francis-walsh/drv8353sm_dev/PCB/DRV8353S_dev_board/Renders/DRV8353S_dev_board.png

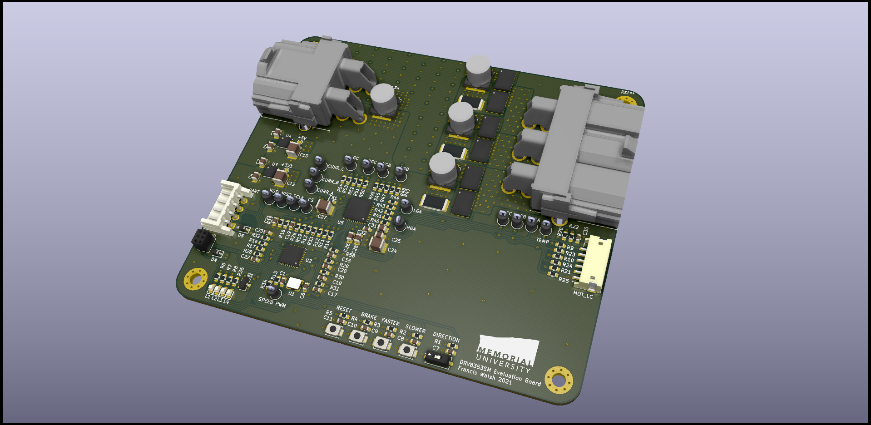
PCB/DRV8353S_dev_board/Renders/DRV8353S_dev_board.png
