francis-walsh/drv8353sm_dev/PCB/DRV8353S_dev_board/componentSelectionSheet.xlsx

Sheet: FETs
Manuf. | MPN | Digi PN | Voltage | Current Rating | Width | Height | Cost Unit | Single or Bridge | Num FETs | Tot Cost
Infineon Technologies | IRFH7545TRPBF | IRFH7545TRPBFCT-ND | 60V | 85A | 5 | 6 | 1.59 | Single | 6 | 9.54
Infineon Technologies | BSC070N10NS5ATMA1 | BSC070N10NS5ATMA1CT-ND | 100V | 80A | 5 | 6 | 2.24 | Single | 6 | 13.44
Diodes Incorporated | DMT12H007LPS-13 | 31-DMT12H007LPS-13CT-ND | 120V | 90A | 5 | 6 | 2.28 | Single | 6 | 13.68
Infineon Technologies | BSC070N10NS3GATMA1 | BSC070N10NS3GATMA1CT-ND | 100V | 90A | 5 | 6 | 2.32 | Single | 6 | 13.92
Infineon Technologies | BSC061N08NS5ATMA1 | BSC061N08NS5ATMA1CT-ND | 80V | 82A | 5 | 6 | 2.42 | Single | 6 | 14.52
Infineon Technologies | BSC040N08NS5ATMA1 | BSC040N08NS5ATMA1CT-ND | 80V | 100A | 5 | 6 | 1.13 | Single | 6 | 6.78
Texas Instruments | CSD19502Q5B | 296-37194-1-ND | 80V | 100A | 5 | 6 | 3.83 | Single | 6 | 22.98
ON Semiconductor | FDMD8680 | FDMD8680OSCT-ND | 80V | 66A | 5 | 6 | 3.9 | Half | 3 | 11.7
STMicroelectronics | STL50DN6F7 | 497-16488-1-ND | 60V | 57A | 5 | 6 | 1.42 | Half | 3 | 4.26
Vishay Siliconix | SQJQ960EL-T1_GE3 | SQJQ960EL-T1_GE3CT-ND | 60V | 63A | 8 | 8 | 2.92 | Half | 3 | 8.76

Sheet: Caps
Manuf. | MPN | Digi PN | Type | Mount Type | Value | Voltage | Tolerance | ESR | W | Depth | Height | Cost Unit | Tot Cost
KEMET | A759KK186M1KAAE075 | 399-A759KK186M1KAAE075-ND | Polymer | THT | 18u | 80V | 20% | 75m | 8 | 8 | 9 | 1.76 | 5.28
Chemi-Con | HHXA630ARA100MF61G | 565-4169-1-ND | Polymer | SMD | 10u | 63V | 0.2 | 120m | 6.6 | 6.6 | 6.1 | 1.91 | 5.73
Rubycon | 63PEV10M6.3X6.1 | 1189-3804-1-ND | Polymer | SMD | 10u | 63V | 20% | 120m | 6.6 | 6.6 | 6.1 | 2.46 | 7.38
Chemi-Con | HHXB630ARA220MF80G | 565-4192-1-ND | Polymer | SMD | 22u | 63V | 20% | 80m | 6.6 | 6.6 | 8 | 1.98 | 5.94
KEMET | A759KS106M2CAAE110 | 399-14157-ND | Polymer | THT | 10u | 160V | 20% | 110m | 8 | 8 | 13 | 1.98 | 5.94
KEMET | A759KS156M2AAAE052 | 399-A759KS156M2AAAE052-ND | Polymer | THT | 15u | 100V | 20% | 52m | 8 | 8 | 13 | 1.91 | 5.73
AVX Corp | 22201C106MAT2A | 478-9622-1-ND | Ceramic | SMD | 10u | 100V | 20% |  | 5.7 | 5 | 2.79 | 2.85 | 8.55 | Same as chum bucket
TDK Corp | CGA6P1X7R1N106M250AC | 445-181609-1-ND | Ceramic | SMD | 10u | 75V | 20% |  | 3.2 | 2.5 | 2.8 | 1.48 | 4.44
TDK Corp | C5750X7S2A106K230KB | 445-13408-1-ND | Ceramic | SMD | 10u | 100V | 10% |  | 5.7 | 5 | 2.5 | 3.1 | 9.3
TDK Corp | CGA9P3X7S2A156M250KB | 445-7948-1-ND | Ceramic | SMD | 15u | 100V | 20% |  | 5.7 | 5 | 2.8 | 4.55 | 13.65
AVX Corp | 12101C475K4Z2A | 478-12101C475K4Z2ACT-ND | Ceramic | SMD | 4.7u | 100V | 20% |  | 3.3 | 2.5 | 2.79 | 1.3 | 3.9 | 3 in a row
Make foot print for 3 tests: 3 parallel 1210s, 1 2220 ceramic, 1 polymer

Sheet: Motor Sheet
Skateboard (https://www.amazon.ca/Retrospec-Drop-Through-Longboard-Skateboard-Complete/dp/B07NXWJ85G)
Wheel Diam | 51 | mm
Wheel Radius | 25.5 | mm
Wheel Circum | 160.14 | mm
Pulley Circum | 46 | mm
Gear Ratio | 2.117647059 | From amazon
Desired Top Speed | 50 | km/h
Desired Top Speed | 13.88888889 | m/s
Wheel w | 544.6623094 | rad/s
Motor w | 1153.402537 | rad/s
Motor RPM | 11014.18293 | RPM
Motor Poles | 14
Electrical Frequncy | 1284.988008 | Hz
