francis-walsh/drv8353sm_dev/PCB/DRV8353S_dev_board/3D LIB/ECS-320-12-33B-7KM-TR.STEP

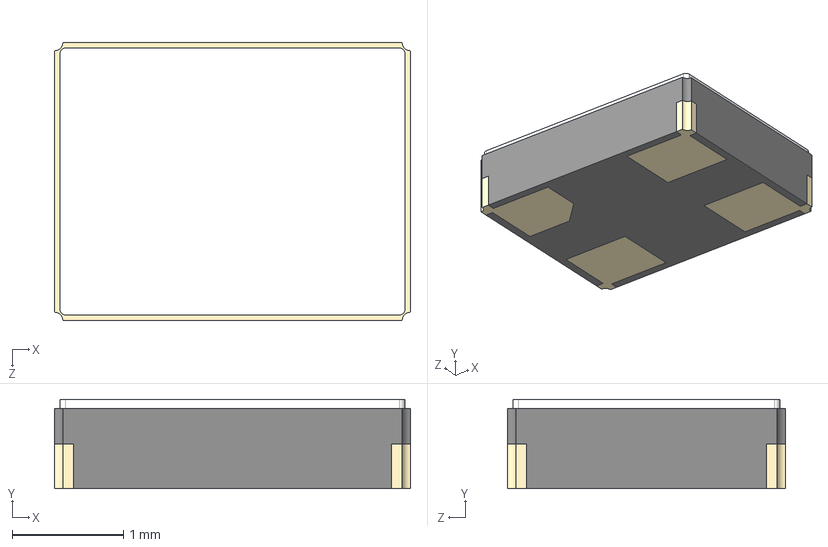
[picture p3: CAD file, 2021-02-27]
PCB/DRV8353S_dev_board/3D LIB/ECS-320-12-33B-7KM-TR.STEP
3.20 x 0.8 x 2.50 mm
