francis-walsh/drv8353sm_dev/PCB/DRV8353S_dev_board/3D LIB/keystone-PN5001.STEP

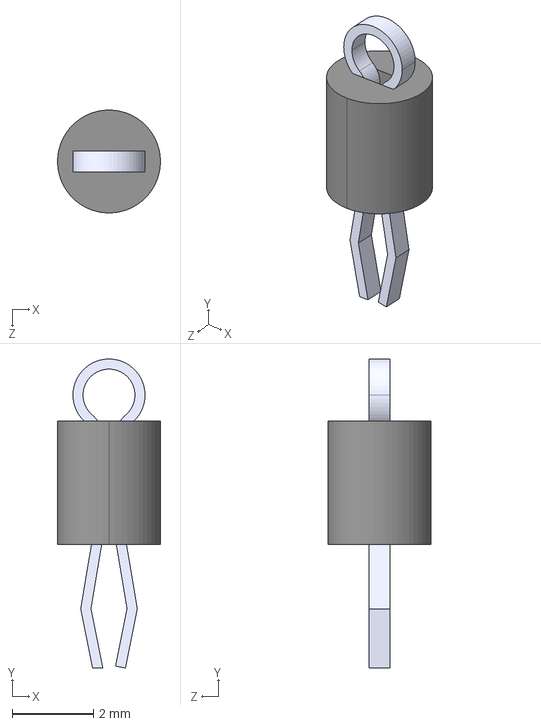
[picture p4: CAD file, 2021-02-27]
PCB/DRV8353S_dev_board/3D LIB/keystone-PN5001.STEP
2.54 x 7.62 x 2.54 mm
