francis-walsh/drv8353sm_dev/PCB/DRV8353S_dev_board/3D LIB/CAP_PEVPFV_6P3X6P1_RUB.step

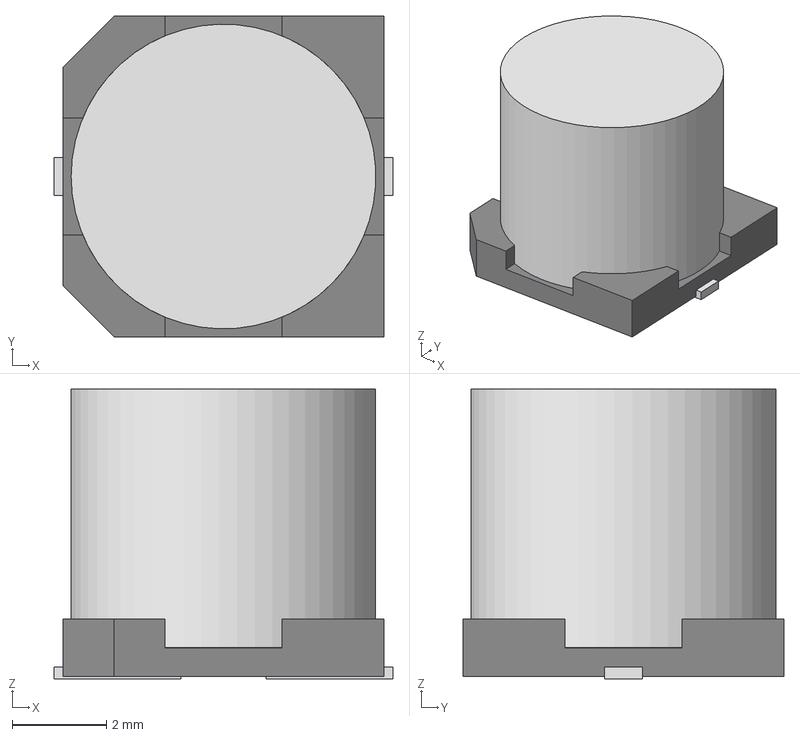
[picture p5: CAD file, 2021-02-27]
PCB/DRV8353S_dev_board/3D LIB/CAP_PEVPFV_6P3X6P1_RUB.step
7.19 x 6.81 x 6.15 mm
