francis-walsh/drv8353sm_dev/PCB/DRV8353S_dev_board/3D LIB/S6B-ZR_JST.step

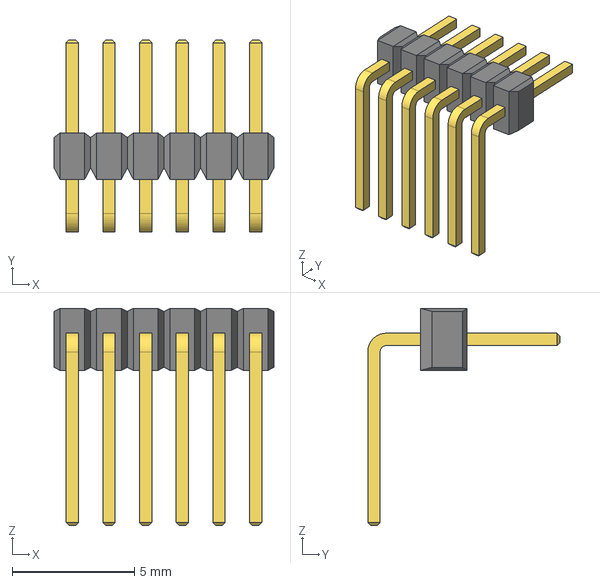
[picture p6: CAD file, 2021-02-27]
PCB/DRV8353S_dev_board/3D LIB/S6B-ZR_JST.step
9.00 x 7.87 x 8.89 mm
