francis-walsh/drv8353sm_dev/PCB/DRV8353S_dev_board/3D LIB/S6B-ZR-SM4A-TF_LF__SN_.step

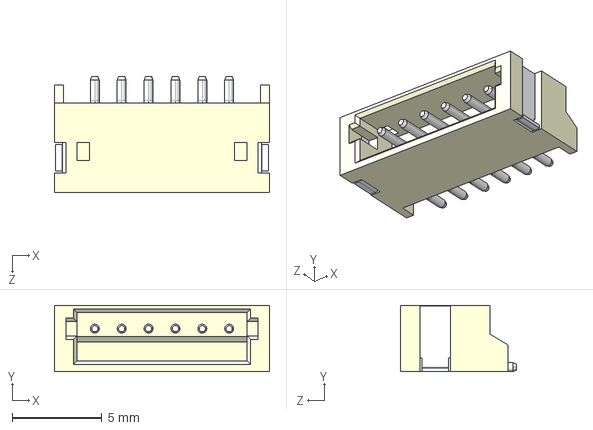
[picture p7: CAD file, 2021-02-26]
PCB/DRV8353S_dev_board/3D LIB/S6B-ZR-SM4A-TF_LF__SN_.step
12.0 x 3.70 x 6.50 mm
