francis-walsh/drv8353sm_dev/PCB/DRV8353S_dev_board/3D LIB/428202213.stp

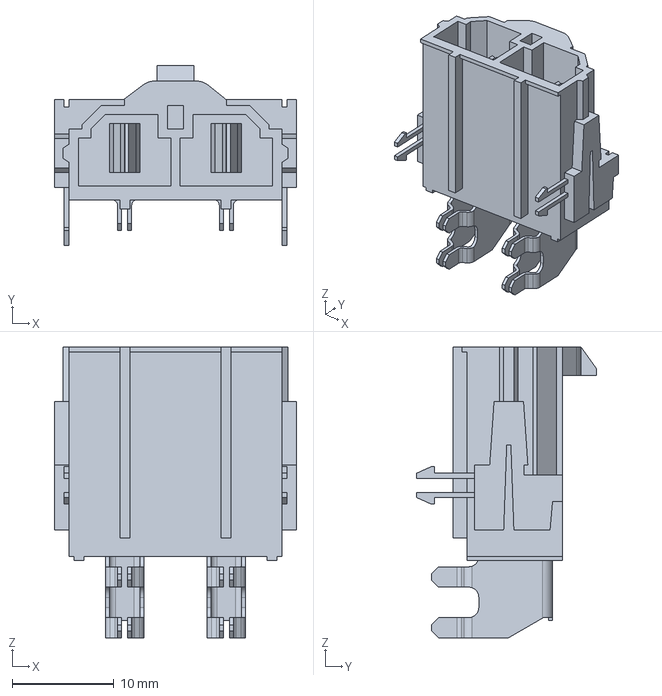
[picture p8: CAD file, 2021-02-26]
PCB/DRV8353S_dev_board/3D LIB/428202213.stp
23.8 x 17.6 x 28.6 mm
