francis-walsh/drv8353sm_dev/PCB/DRV8353S_dev_board/3D LIB/2018431031.stp

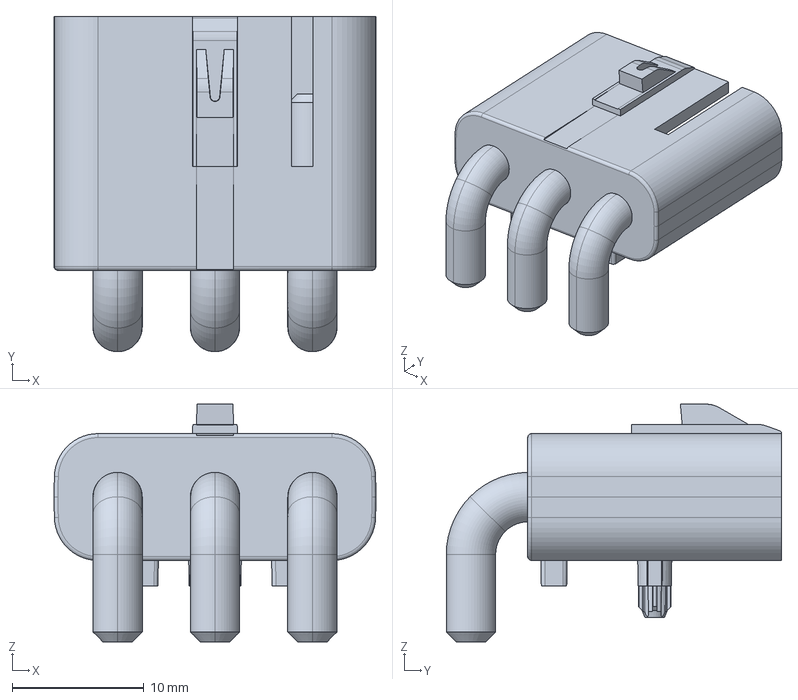
[picture p10: CAD file, 2021-02-26]
PCB/DRV8353S_dev_board/3D LIB/2018431031.stp
24.5 x 25.5 x 18.1 mm
