francis-walsh/drv8353sm_dev/PCB/DRV8353S_dev_board/DRV8353S_dev_board.kicad_pcb

## KiCad design PCB/DRV8353S_dev_board/DRV8353S_dev_board.kicad_pcb (2021-03-09)

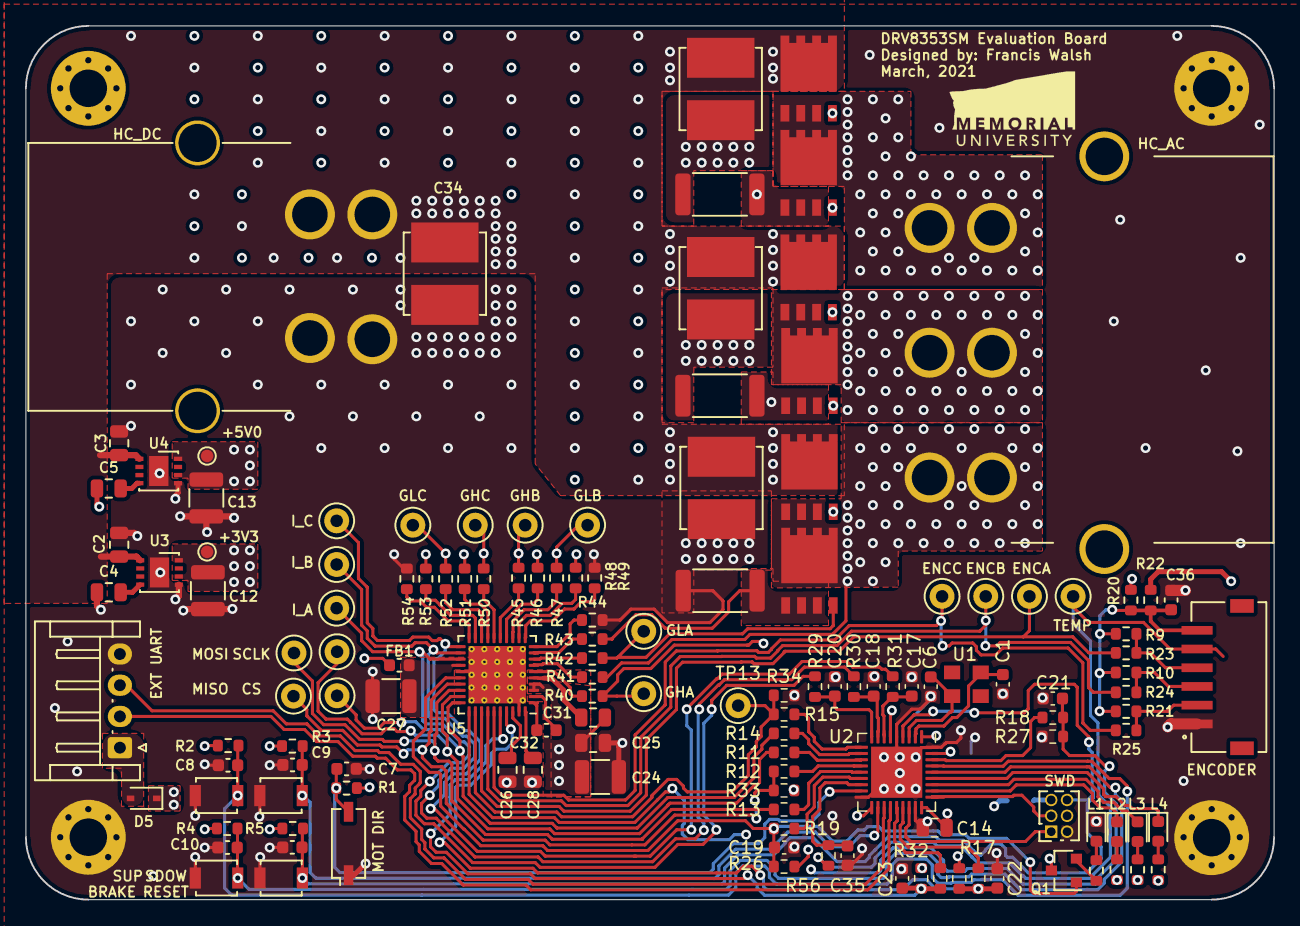
[picture p11: board DRV8353S_dev_board.kicad_pcb from above]

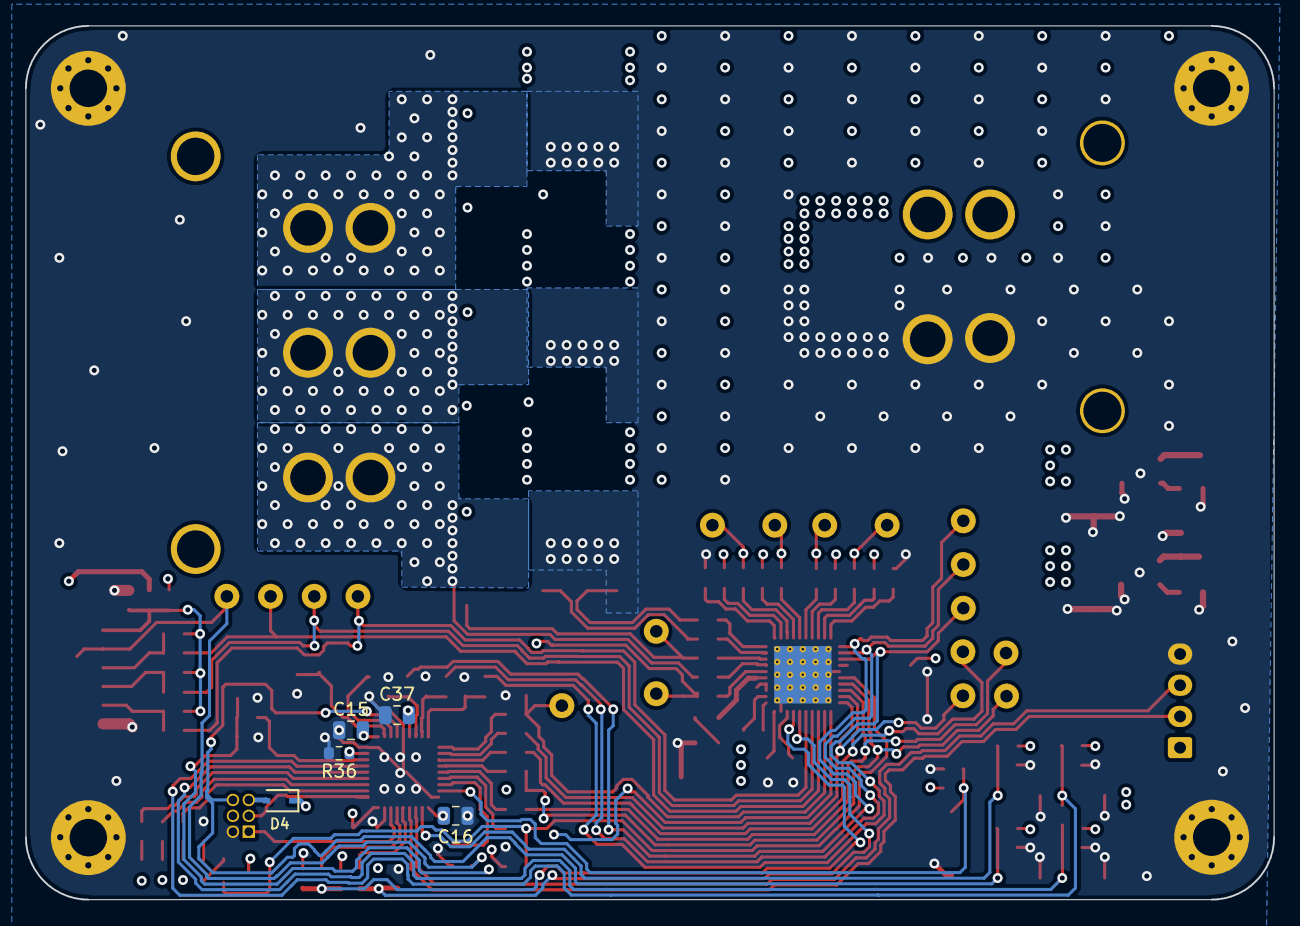
[picture p12: board DRV8353S_dev_board.kicad_pcb from below]

Board: 4 copper layers, 100.0 x 70.0 mm, 141 parts (5 on the bottom side), 96 nets.

Parts:
+3V3, +5V0: SMD; TestPoint_Pad_D1.0mm
BRAKE: B3U; SW_SPST_B3U-1000P
C1, C6: 12pF; C_0603_1608Metric
C2, C3, C14, C15, C16, C26, C28, C31, C37: 1uF; C_0805_2012Metric
C4, C5, C25: 0.1uF; C_0805_2012Metric
C7, C8, C9, C10, C11, C17, C18, C19, C20, C21, C22, C23, C35, C36: 22nF; C_0603_1608Metric
C12, C13, C24, C27: 10uF; C_1210_3225Metric
C29, C30, C33, C34: 10uF; bridge_caps
C32: 47nF; C_0603_1608Metric
CS: THT; keystone_5001
D4, D5: BAT46; D_SOD-323
ENCA: THT; keystone_5001
ENCB: THT; keystone_5001
ENCC: THT; keystone_5001
ENCODER: MOT_LC; JST_S6B-ZR-SM4A-TF(LF)(SN)
EXT UART: EXT_CMD; JST_EH_S4B-EH_1x04_P2.50mm_Horizontal
FB1: FB; L_0603_1608Metric
GHA: THT; keystone_5001
GHB: THT; keystone_5001
GHC: THT; keystone_5001
GLA: THT; keystone_5001
GLB: THT; keystone_5001
GLC: THT; keystone_5001
HC_AC: PHASE; MOLEX_0428203213
HC_DC: HC_POWER; MOLEX_428202213
I_A: THT; keystone_5001
I_B: THT; keystone_5001
I_C: THT; keystone_5001
L1, L2: RD; LED_0603_1608Metric
L3, L4: GN; LED_0603_1608Metric
MISO: THT; keystone_5001
MOSI: THT; keystone_5001
MOT DIR: DIP; SW_DIP_SPSTx01_Slide_Copal_CHS-01A_W5.08mm_P1.27mm_JPin
Q1: BSS84; SOT-23
Q2, Q3, Q4, Q5, Q6, Q7: CSD19502
R1, R2, R3, R4, R5, R9, R10, R21, R26, R27, R28, R32, R33, R34, R35, R36: 2.2k; R_0603_1608Metric
R6, R7, R8: 1k; R_0603_1608Metric
R11, R12, R13, R14, R15, R16, R17, R18, R19, R20, R22, R23, R24, R25, R40, R41, R42, R43, R44, R45, R46, R47, R48, R49, R50, R51, R52, R53, R54: 0; R_0603_1608Metric
R29, R30, R31, R56: 330; R_0603_1608Metric
R38, R39, R55: 500u; R_2512_6332Metric
RESET: B3U; SW_SPST_B3U-1000P
SCLK: THT; keystone_5001
SDOW: B3U; SW_SPST_B3U-1000P
SUP: B3U; SW_SPST_B3U-1000P
SWD: SWD; PinSocket_2x03_P1.27mm_Vertical
TEMP: THT; keystone_5001
TP13: THT; keystone_5001
U1: ECS-33B
U2: STM32F103TBUx; QFN-36-1EP_6x6mm_P0.5mm_EP4.1x4.1mm
U3: MIC5283-3.3ML-TR; DFN-8-1EP_3x3mm_P0.65mm_EP1.55x2.4mm
U4: MIC5283-5.0ML-TR; DFN-8-1EP_3x3mm_P0.65mm_EP1.55x2.4mm
U5: DRV8353SM; QFN-40-1EP_6x6mm_P0.5mm_EP4.6x4.6mm_ThermalVias

Connections:
+3V3: +3V3.1, C12.1, C14.2, C15.2, C16.2, C37.2, D4.1, D5.1, FB1.2, Q1.3, R1.2, R2.2, R3.2, R4.2, R5.2, R6.2, R7.2, R8.2, R20.1, R26.2, R28.2, R32.2, R33.2, U2.1, U2.6, U2.19, U2.27, U3.6, U3.8
+5V: +5V0.1, C13.1, R22.1, U4.6, U4.8
/DIRECTION: C23.2, R16.2, R32.1, U5.36
/DIRECTION_DIP: C7.2, MOT DIR.2, R1.1, U2.17
/DIRECTION_JMP: R16.1, U2.23
/DRV8353_EN: C21.2, R18.2, R27.2, U5.31
/DRV8353_EN_JMP: R18.1, U2.34
/EXT_UART_RX: EXT UART.2, U2.22
/EXT_UART_TX: EXT UART.3, U2.21
/GATE_HI_A: GHA.1, Q2.2, R40.2
/GATE_HI_B: GHB.1, Q4.2, R45.2
/GATE_HI_C: GHC.1, Q6.2, R50.2
/GATE_LO_A: GLA.1, Q3.2, R42.2
/GATE_LO_B: GLB.1, Q5.2, R47.2
/GATE_LO_C: GLC.1, Q7.2, R52.2
/HALLA: ENCA.1, R23.2, U5.33
/HALLA_JMP: ENCODER.4, R9.1, R23.1
/HALLB: ENCB.1, R24.2, U5.34
/HALLB_JMP: ENCODER.3, R10.1, R24.1
/HALLC: ENCC.1, R25.2, U5.35
/HALLC_JMP: ENCODER.2, R21.1, R25.1
/I_PHASE_A: I_A.1, R29.2, U5.23
/I_PHASE_A_JMP: C20.1, R29.1, U2.9
/I_PHASE_B: I_B.1, R30.2, U5.22
/I_PHASE_B_JMP: C18.1, R30.1, U2.8
/I_PHASE_C: I_C.1, R31.2, U5.21
/I_PHASE_C_JMP: C17.1, R31.1, U2.7
/MISO: MISO.1, R12.2, R33.1, U5.27
/MISO_JMP: R12.1, U2.13
/MOSI: MOSI.1, R13.2, U5.28
/MOSI_JMP: R13.1, U2.14
/MOT_A: HC_AC.3, Q2.3, Q3.1, R41.2
/MOT_B: HC_AC.2, Q4.3, Q5.1, R46.2
/MOT_C: HC_AC.1, Q6.3, Q7.1, R51.2
/MOT_TEMP: ENCODER.5, R56.2, TEMP.1
/MOT_TEMP_JMP: C35.1, R56.1, U2.16
/SCLK: R11.2, SCLK.1, U5.29
/SCLK_JMP: R11.1, U2.12
/SHUNT_POS_A: Q3.3, R38.1, R43.2
/SHUNT_POS_B: Q5.3, R39.1, R48.2
/SHUNT_POS_C: Q7.3, R53.2, R55.1
/SPEED_PWM: R15.2, R34.2, TP13.1, U5.32
/SPEED_PWM_JMP: R15.1, U2.10
/SWCLK: SWD.3, U2.28
/SWDIO: SWD.1, U2.25
/XTAL_IN: C1.1, U1.1, U2.2
/XTAL_OUT: C6.1, U1.3, U2.3
/~BRAKE: C22.2, R17.2, R28.1, U5.37
/~BRAKE_JMP: R17.1, U2.24
/~BRAKE_PB: BRAKE.2, C10.2, R4.1, U2.32
/~DRV8353_CS: CS.1, R14.2, U5.30
/~DRV8353_CS_JMP: R14.1, U2.11
/~DRV8353_FAULT: C19.2, Q1.1, R19.2, R26.1, U5.26
/~DRV8353_FAULT_JMP: R19.1, U2.15
/~LED_DIR: L4.1, U2.31
/~LED_SPEED: L3.1, U2.30
/~RESET_PB: C11.2, R5.1, RESET.2, SWD.6, U2.4
/~SPEED_DOWN_PB: C9.2, R3.1, SDOW.2, U2.20
/~SPEED_UP_PB: C8.2, R2.1, SUP.2, U2.33
/~SYS_FAULT: L2.1, U2.29
GND: BRAKE.1, C1.2, C2.1, C3.1, C4.1, C5.1, C6.2, C7.1, C8.1, C9.1, C10.1, C11.1, C12.2, C13.2, C14.1, C15.1, C16.1, C17.2, C18.2, C19.1, C20.2, C21.1, C22.1, C23.1, C24.1, C25.2, C26.2, C27.2, C28.2, C29.2, C30.2, C33.2, C34.2, C35.2, C36.2, C37.1, ENCODER.1, EXT UART.4, HC_DC.1, L1.1, MOT DIR.1, R27.1, R34.1, R36.2, R38.2, R39.2, R44.2, R49.2, R54.2, R55.2, RESET.1, SDOW.1, SUP.1, SWD.2, U2.5, U2.18, U2.26, U2.36, U2.37, U3.5, U3.9, U4.5, U4.9, U5.25, U5.39, U5.41
unnamed: C4.2, U3.4
unnamed: C5.2, U4.4
unnamed: C26.1, U5.38
unnamed: C27.1, FB1.1, U5.24
unnamed: C28.1, U5.40
unnamed: C31.2, U5.5
unnamed: C32.1, U5.2
unnamed: C32.2, U5.1
unnamed: C36.1, ENCODER.6, R9.2, R10.2, R20.2, R21.2, R22.2
unnamed: L4.2, R6.1
unnamed: L3.2, R7.1
unnamed: L2.2, R8.1
unnamed: D4.2, SWD.5
unnamed: D5.2, EXT UART.1
unnamed: L1.2, R35.1
unnamed: Q1.2, R35.2
unnamed: R36.1, U2.35
unnamed: R40.1, U5.6
unnamed: R41.1, U5.7
unnamed: R42.1, U5.8
unnamed: R43.1, U5.9
unnamed: R44.1, U5.10
unnamed: R45.1, U5.15
unnamed: R46.1, U5.14
unnamed: R47.1, U5.13
unnamed: R48.1, U5.12
unnamed: R49.1, U5.11
unnamed: R50.1, U5.16
unnamed: R51.1, U5.17
unnamed: R52.1, U5.18
unnamed: R53.1, U5.19
unnamed: R54.1, U5.20
unnamed: U3.2, U3.3, U3.7
unnamed: U4.2, U4.3, U4.7
Vdrive: C2.2, C3.2, C24.2, C25.1, C29.1, C30.1, C31.1, C33.1, C34.1, HC_DC.2, Q2.1, Q4.1, Q6.1, U3.1, U4.1, U5.3, U5.4
