francis-walsh/drv8353sm_dev/Firmware/Firmware.ioc

Mcu.UserName=STM32F103TBUx
PA0-WKUP.GPIO_Label=PHASE_C
PA0-WKUP.Signal=ADCx_IN0
PA1.GPIO_Label=PHASE_B
PA1.Signal=ADCx_IN1
PA10.Signal=USART1_RX
PA11.GPIO_Label=DRV_DIR
PA11.Signal=GPIO_Output
PA12.GPIO_Label=DRV_BRAKE
PA12.Signal=GPIO_Output
PA13.Signal=SYS_JTMS-SWDIO
PA14.Signal=SYS_JTCK-SWCLK
PA15.GPIO_Label=LED_FAULT
PA15.Signal=GPIO_Output
PA2.GPIO_Label=PHASE_A
PA2.Signal=ADCx_IN2
PA3.GPIO_Label=SPEED_PWM
PA3.Signal=S_TIM2_CH4
PA4.GPIO_Label=DRV_CS
PA4.Signal=GPIO_Output
PA5.Signal=SPI1_SCK
PA6.Signal=SPI1_MISO
PA7.Signal=SPI1_MOSI
PA8.GPIO_Label=S_DOWN_PB
PA8.Signal=GPIO_Input
PA9.Signal=USART1_TX
PB0.GPIO_Label=DRV_FAULT
PB0.Signal=GPXTI0
PB1.GPIO_Label=MOT_TEMP
PB1.Signal=ADCx_IN9
PB2.GPIO_Label=DIR_DIP
PB2.Signal=GPIO_Input
PB3.GPIO_Label=LED_SPEED
PB3.Signal=S_TIM2_CH2
PB4.GPIO_Label=LED_DIR
PB4.Signal=GPIO_Output
PB5.GPIO_Label=BRAKE_PB
PB5.Signal=GPIO_Input
PB6.GPIO_Label=S_UP_PB
PB6.Signal=GPIO_Input
PB7.GPIO_Label=DRV_EN
PB7.Signal=GPIO_Output
PD0-OSC_IN.Signal=RCC_OSC_IN
PD1-OSC_OUT.Signal=RCC_OSC_OUT
