francis-walsh/drv8353sm_dev/(commit log)

2021-02-26 Initial commit
    Work done so far.
    [2018431031.stp, 428202213.stp, 428203213.stp, DRV8353.sch, DRV8353S_dev_board.kicad_pcb, DRV8353S_dev_board.sch, MCU.sch, S6B-ZR-SM4A-TF_LF__SN_.step]
2021-02-27 High Current Routing planning
    Planning how the high current routing will work with the gate drive signals
    [CAP_PEVPFV_6P3X6P1_RUB.step, DRV8353S_dev_board.kicad_pcb, DRV8353S_dev_board.sch, ECS-320-12-33B-7KM-TR.STEP, S6B-ZR_JST.step, keystone-PN5001.STEP]
2021-03-01 more routing work
    [DRV8353S_dev_board.kicad_pcb, DRV8353S_dev_board.sch]
2021-03-01 Final (?) layout
    [DRV8353S_dev_board.kicad_pcb, DRV8353S_dev_board.sch]
2021-03-02 Final Routing
    Moved around encoder stuff. Also added decoupling capacitor near encoder connector.
    [DRV8353S_dev_board.kicad_pcb, DRV8353S_dev_board.sch]
2021-03-02 High Current Routing
    [DRV8353S_dev_board.kicad_pcb]
2021-03-02 Most DRV routing done.
    [DRV8353S_dev_board.kicad_pcb, DRV8353S_dev_board.sch]
2021-03-03 Finished routing (?)
    All signals routed. No DRC errors.
    [DRV8353S_dev_board.kicad_pcb, DRV8353S_dev_board.sch]
2021-03-03 final final routing
    [DRV8353S_dev_board.kicad_pcb]
2021-03-03 Fixed silkscreen and added BOM
    [DRV8353S_dev_board.csv, DRV8353S_dev_board.kicad_pcb, DRV8353S_dev_board.sch]
2021-03-05 Changed MCU due to low digikey stock. Also new routing
    [DRV8353S_dev_board-B_Cu.gbr, DRV8353S_dev_board-B_Mask.gbr, DRV8353S_dev_board-B_Paste.gbr, DRV8353S_dev_board-B_SilkS.gbr, DRV8353S_dev_board-Edge_Cuts.gbr, DRV8353S_dev_board-F_Cu.gbr, DRV8353S_dev_board-F_Mask.gbr, DRV8353S_dev_board-F_Paste.gbr]
2021-03-08 updated MCU due to low digi stock. This was bad routing to get new MCU pinout
    [DRV8353S_dev_board.kicad_pcb, DRV8353S_dev_board.sch]
2021-03-08 Good routing
    [DRV8353S_dev_board.kicad_pcb, DRV8353S_dev_board.sch]
2021-03-09 As ordered PCB
    [DRV8353S_dev_board-B_Cu.gbr, DRV8353S_dev_board-B_Mask.gbr, DRV8353S_dev_board-B_Paste.gbr, DRV8353S_dev_board-B_SilkS.gbr, DRV8353S_dev_board-Edge_Cuts.gbr, DRV8353S_dev_board-F_Cu.gbr, DRV8353S_dev_board-F_Mask.gbr, DRV8353S_dev_board-F_Paste.gbr]
